controlXic/Maps_Tracker_Cockpit/docs/bike.png

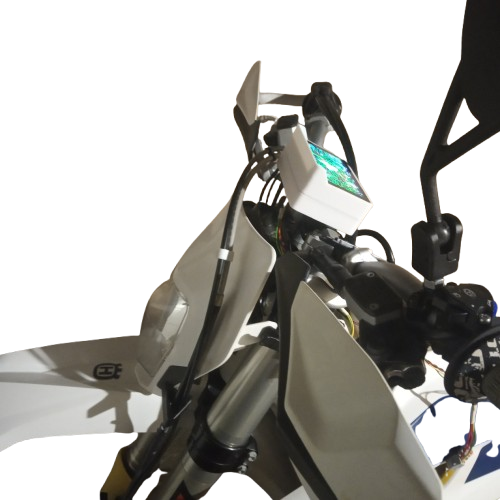
docs/bike.png
