controlXic/Maps_Tracker_Cockpit/docs/brd.png

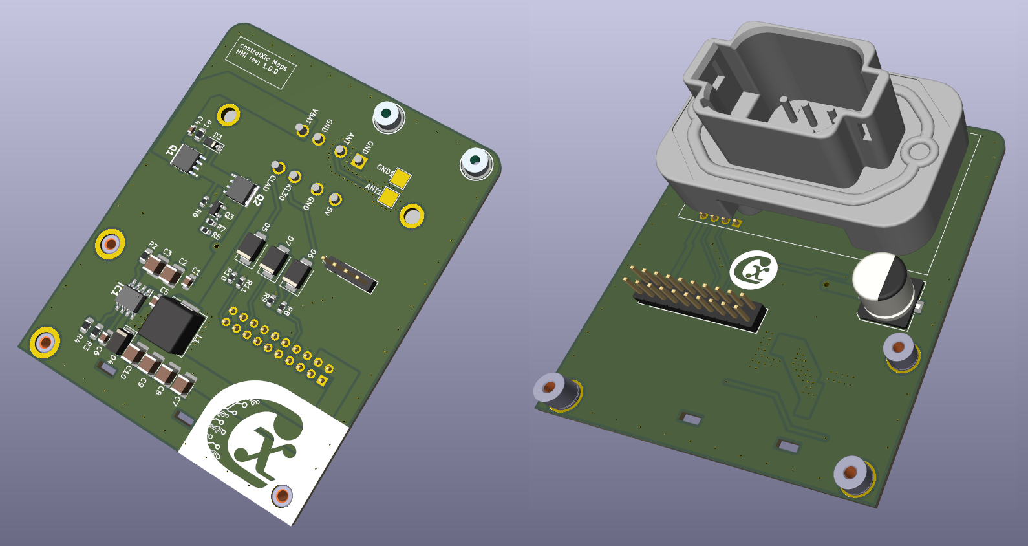
docs/brd.png
