controlXic/Maps_Tracker_Cockpit/docs/devB.png

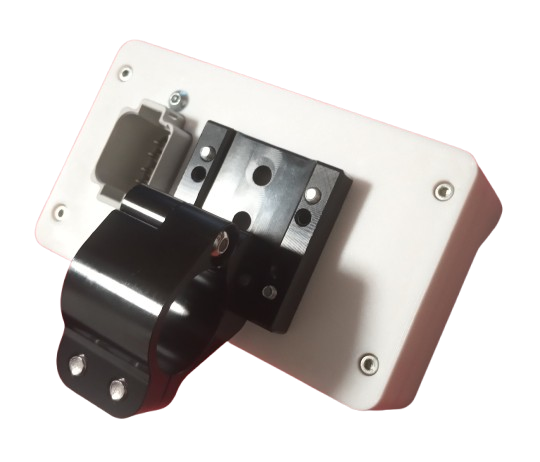
docs/devB.png
