controlXic/Maps_Tracker_Cockpit/docs/devFull.png

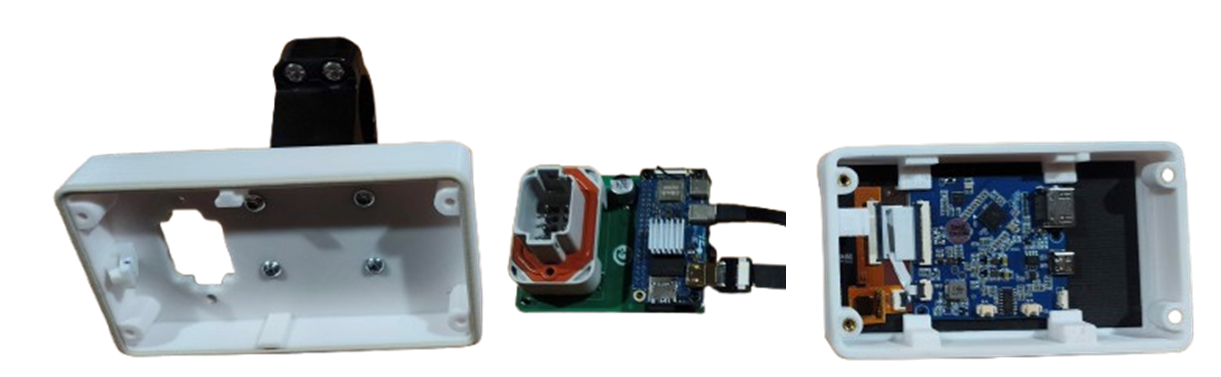
docs/devFull.png
