controlXic/Maps_Tracker_Cockpit/docs/devMoto.jpg

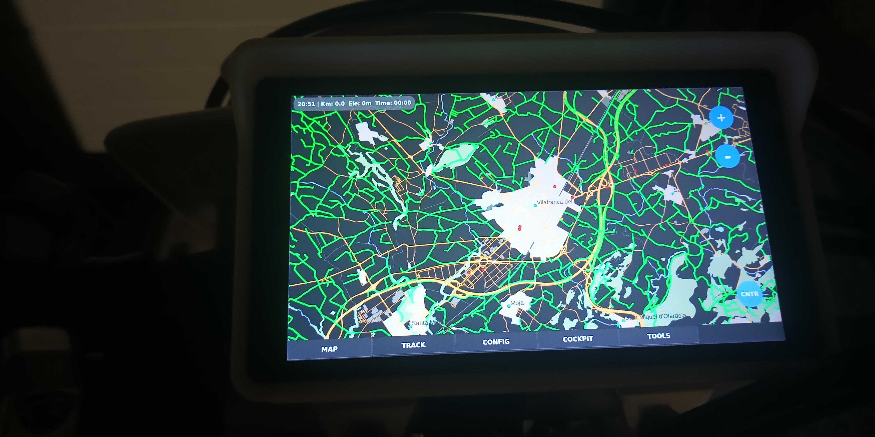
docs/devMoto.jpg
