controlXic/Maps_Tracker_Cockpit/docs/devT.png

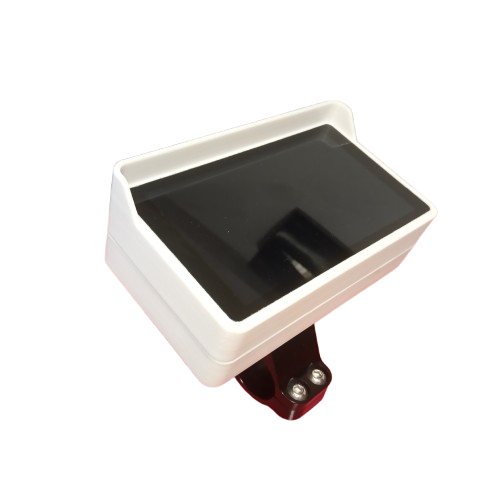
docs/devT.png
