controlXic/Maps_Tracker_Cockpit/docs/pcbB.png

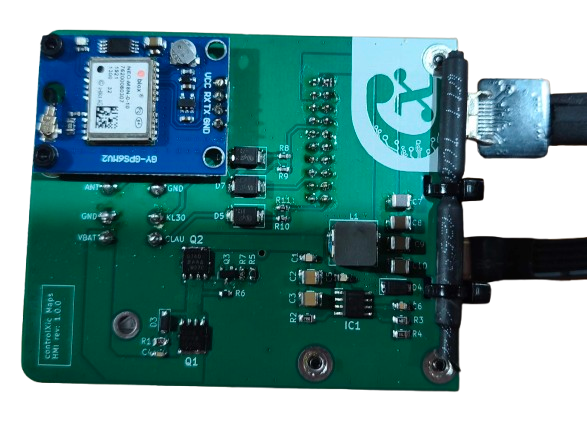
docs/pcbB.png
