controlXic/Maps_Tracker_Cockpit/01_PCB/PCB_C_X_mapsDevNmos/BOM/PCB_C_X_mapsDevNmos.xlsx

Id | Designator | Footprint | Quantity | Designation | Supplier and ref
12 | C1,C5 | C_0805_2012Metric_Pad1.18x1.45mm_HandSolder | 2 | 0.1uF
2 | C11 | CP_Elec_10x10.5 | 1 | C_Polarized_Small
16 | C3,C2 | C_1210_3225Metric_Pad1.33x2.70mm_HandSolder | 2 | 2.2uF
26 | C4 | C_0603_1608Metric | 1 | 15nF
17 | C6 | C_0805_2012Metric_Pad1.18x1.45mm_HandSolder | 1 | 22nF
10 | C7,C10,C9,C8 | C_1210_3225Metric_Pad1.33x2.70mm_HandSolder | 4 | 47uF
25 | D3 | D_SOD-123 | 1 | SZMMSZ5240BT1G
20 | D4 | Vishay_SMPA | 1 | V8PA22HM3/I
9 | D5,D6,D7 | D_SMB | 3 | MBRS120T3G
13 | GND,ANT | TestPoint_Pad_3.0x3.0mm | 2 | TestPoint
4 | H2,H3,H1 | SMTSOM252ET | 3 | SMTSO-M25-2ET
1 | H5,H4 | 9774027151R | 2 | 9774027151R
27 | IC1 | SOIC127P600X170-9N | 1 | LMR14050SSQDDARQ1
3 | J1 | DT1508PA | 1 | DT15-08PA
18 | J2 | PinHeader_1x04_P2.54mm_Vertical | 1 | Conn_01x04_Socket
5 | J4 | PinHeader_2x10_P2.54mm_Vertical | 1 | Conn_02x10_Odd_Even
24 | L1 | L_APV_APH0850 | 1 | 8.2uH
11 | Q1,Q2 | SQJA72EPT1_GE3 | 2 | SQJ403EP-T1_GE3
14 | Q3 | SOT-23 | 1 | SI2300DS-T1-BE3
22 | R1 | R_0805_2012Metric | 1 | 12k
19 | R11 | R_0603_1608Metric | 1 | 2k2
6 | R2 | R_0805_2012Metric_Pad1.20x1.40mm_HandSolder | 1 | 86k6
23 | R3 | R_0805_2012Metric_Pad1.20x1.40mm_HandSolder | 1 | 100k
21 | R4 | R_0805_2012Metric_Pad1.20x1.40mm_HandSolder | 1 | 17.8k
8 | R6,R7 | R_0603_1608Metric | 2 | 47k
7 | R8,R10,R5 | R_0603_1608Metric | 3 | 10k
15 | R9 | R_0603_1608Metric | 1 | 3k
Components contraconnector
 |  | DT06-08SA | 2
 |  | 0462-201-16141 | 20
 |  | W8S | 2
 |  | Revisar crimps contraconnecoor
Cistella
https://www.mouser.es/es/Tools/SavedCart/Share?AccessID=dd964511a3
