controlXic/Maps_Tracker_Cockpit/02_CAD/01_STL/devBottom.stl

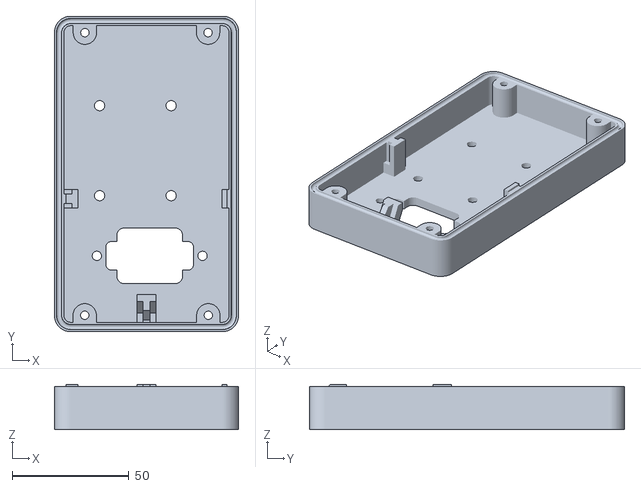
[picture p10: CAD file, 2026-11-03]
02_CAD/01_STL/devBottom.stl
78.7 x 134.9 x 19.4
