controlXic/Maps_Tracker_Cockpit/02_CAD/01_STL/5inch-720x1280-lcd_3D_Drawing.stl

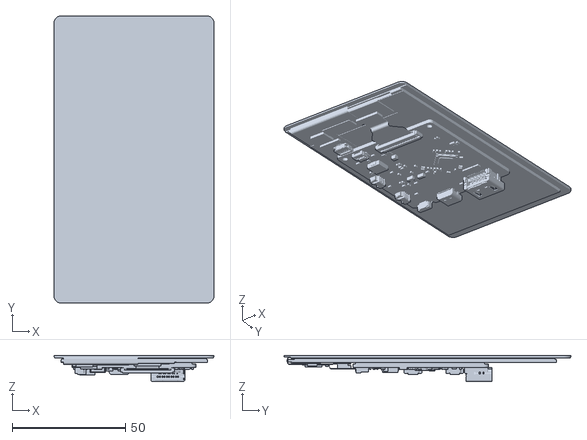
[picture p11: CAD file, 2026-11-03]
02_CAD/01_STL/5inch-720x1280-lcd_3D_Drawing.stl
70.7 x 126.9 x 11.6
