controlXic/Maps_Tracker_Cockpit/02_CAD/01_STL/devTop.stl

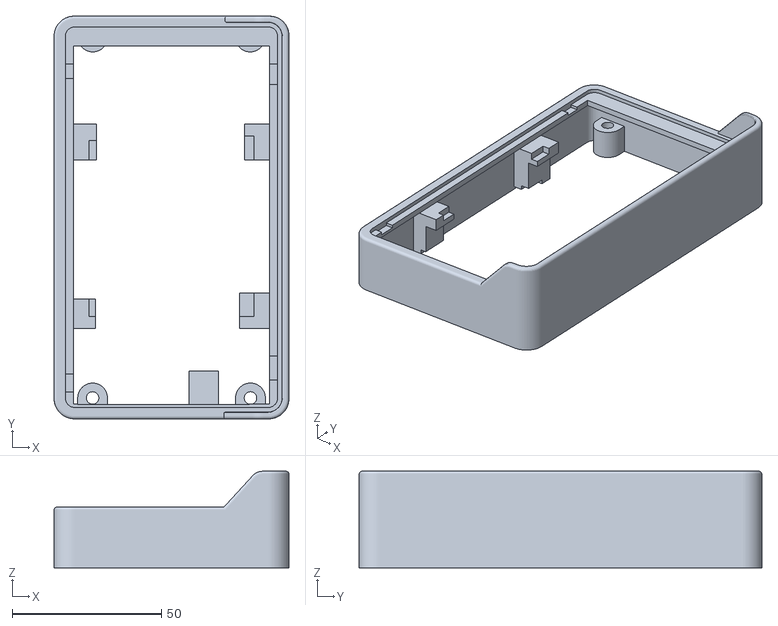
[picture p12: CAD file, 2026-11-03]
02_CAD/01_STL/devTop.stl
78.7 x 134.9 x 32.4
