controlXic/Maps_Tracker_Cockpit/(list of files, cad)

Other CAD files:
02_CAD/00_WORK/cx_maps_case-utils.skp
