controlXic/Maps_Tracker_Cockpit/01_PCB/PCB_C_X_mapsDevNmos/PCB_C_X_mapsDevNmos.kicad_pcb

## KiCad design 01_PCB/PCB_C_X_mapsDevNmos/PCB_C_X_mapsDevNmos.kicad_pcb (2026-11-03)

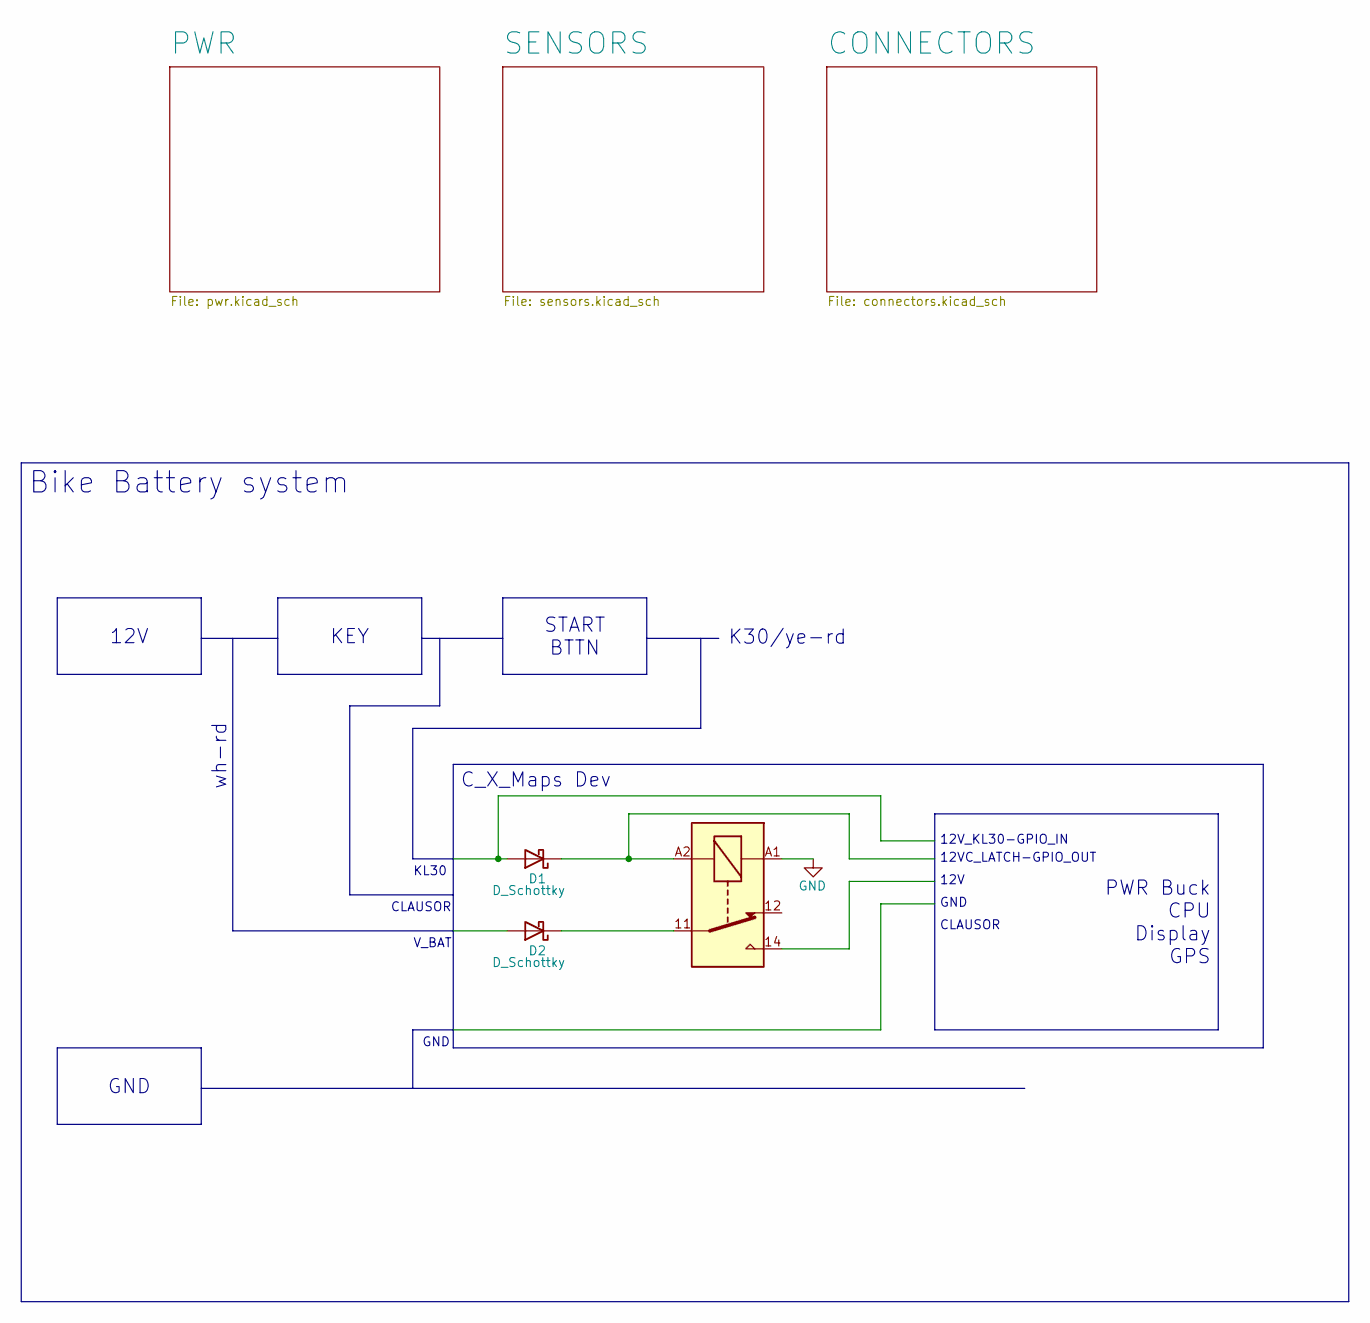
[picture p13: schematic PCB_C_X_mapsDevNmos.kicad_sch]

Parts:
D1, D2: D_Schottky; Vishay_SMPA
K1: Fujitsu_FTR-LYCA005x; Relay_SPDT_Fujitsu_FTR-LYCA005x_FormC_Vertical

Connections:
unnamed: D1.1 (K), K1.A2
unnamed: D2.1 (K), K1.11

Notes on the sheet:
CLAUSOR
12VC_LATCH-GPIO_OUT
V_BAT
GND
KL30
12V
wh-rd
K30/ye-rd
12V_KL30-GPIO_IN
START BTTN
Bike Battery system
PWR Buck CPU Display GPS
KEY
C_X_Maps Dev

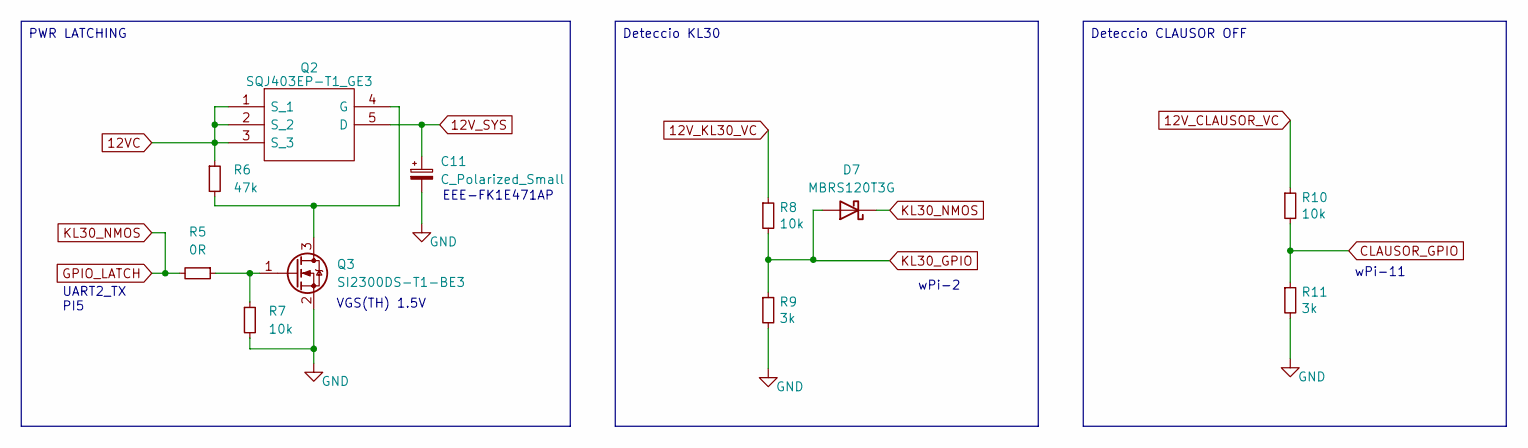
[picture p14: schematic sensors.kicad_sch]

Parts:
C11: C_Polarized_Small; CP_Elec_10x10.5
D7: MBRS120T3G; D_SMB
Q2: SQJ403EP-T1_GE3; SQJA72EPT1_GE3; Manufacturer_Part_Number SQJ481EP-T1_GE3; Mouser Part Number 78-SQJ481EP-T1_GE3
Q3: SI2300DS-T1-BE3; SOT-23
R5: 0R; R_0603_1608Metric
R6: 47k; R_0603_1608Metric
R7, R8, R10: 10k; R_0603_1608Metric
R9, R11: 3k; R_0603_1608Metric

Connections:
12VC: Q2.1 (S_1), Q2.2 (S_2), Q2.3 (S_3), R6.1; also elsewhere on the board
12V_CLAUSOR_VC: R10.1; also elsewhere on the board
12V_KL30_VC: R8.1; also elsewhere on the board
12V_SYS: C11.1, Q2.5 (D); also elsewhere on the board
CLAUSOR_GPIO: R10.2, R11.1; also elsewhere on the board
GND: C11.2, Q3.2 (S), R7.2, R9.2, R11.2; also elsewhere on the board
GPIO_LATCH: D7.1 (K), R5.2; also elsewhere on the board
KL30_GPIO: D7.2 (A), R8.2, R9.1; also elsewhere on the board
unnamed: Q2.4 (G), Q3.3 (D), R6.2
unnamed: Q3.1 (G), R5.1, R7.1

Notes on the sheet:
VGS(TH) 1.5V
wPi-11
EEE-FK1E471AP
wPi-2
UART2_TX PI5
Deteccio CLAUSOR OFF
Deteccio KL30
PWR LATCHING

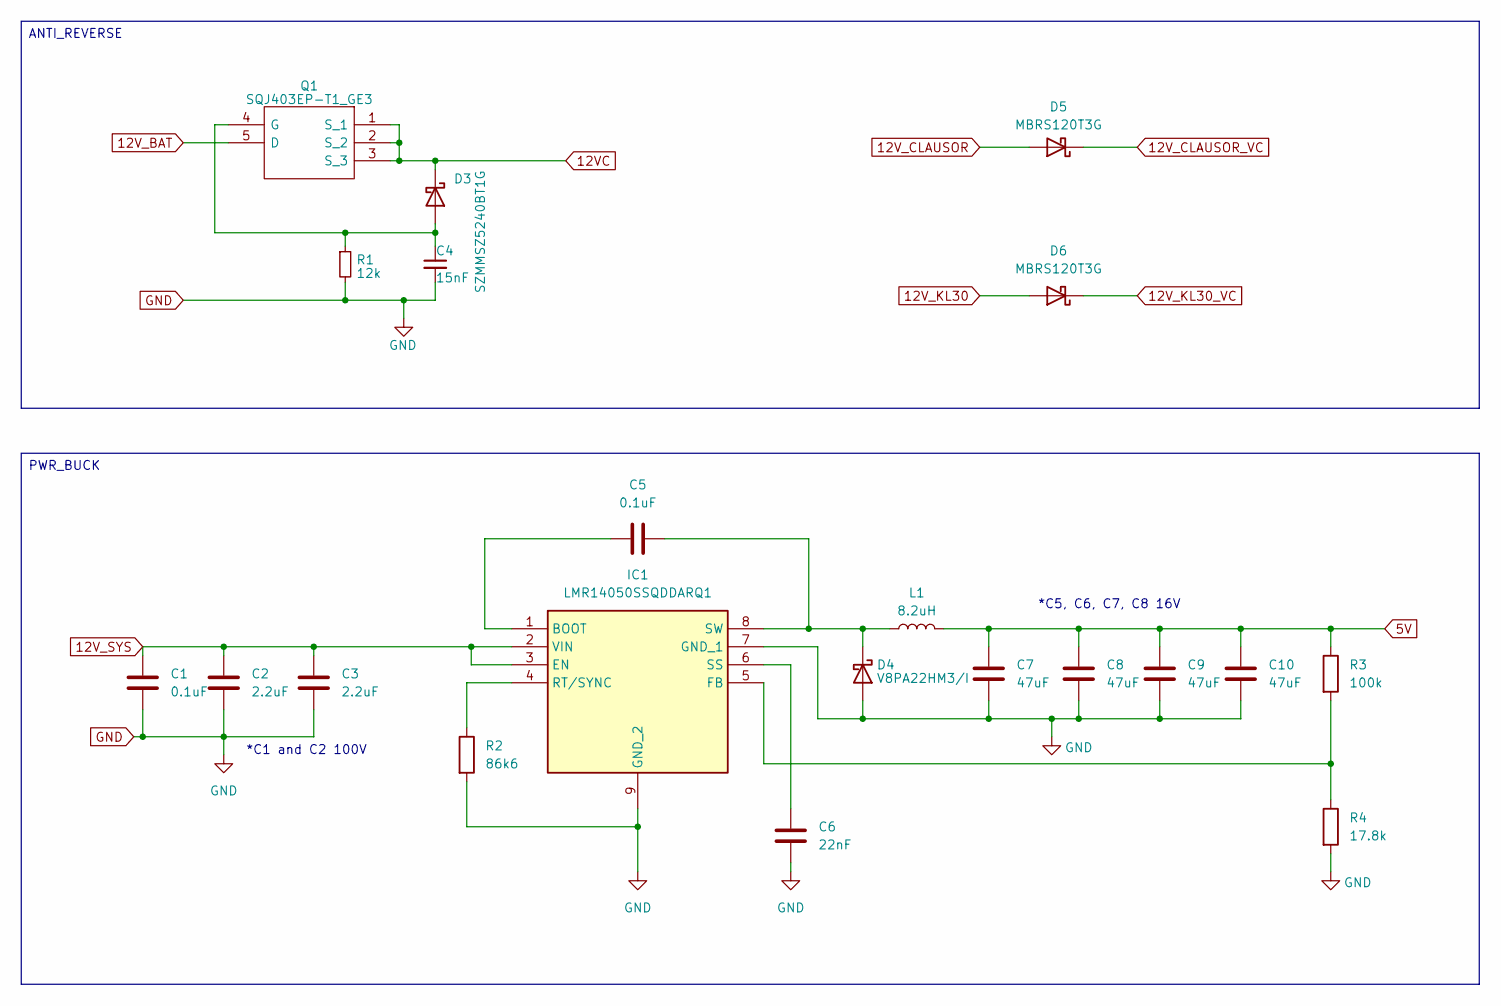
[picture p15: schematic pwr.kicad_sch]

Parts:
C1, C5: 0.1uF; C_0805_2012Metric_Pad1.18x1.45mm_HandSolder
C2, C3: 2.2uF; C_1210_3225Metric_Pad1.33x2.70mm_HandSolder
C4: 15nF; C_0603_1608Metric
C6: 22nF; C_0805_2012Metric_Pad1.18x1.45mm_HandSolder
C7, C8, C9, C10: 47uF; C_1210_3225Metric_Pad1.33x2.70mm_HandSolder
D3: SZMMSZ5240BT1G; D_SOD-123
D4: V8PA22HM3/I; Vishay_SMPA
D5, D6: MBRS120T3G; D_SMB
IC1: LMR14050SSQDDARQ1; SOIC127P600X170-9N; Mouser Part Number 595-LMR14050SSDDARQ1
L1: 8.2uH; L_APV_APH0850
Q1: SQJ403EP-T1_GE3; SQJA72EPT1_GE3; Manufacturer_Part_Number SQJ481EP-T1_GE3; Mouser Part Number 78-SQJ481EP-T1_GE3
R1: 12k; R_0805_2012Metric
R2: 86k6; R_0805_2012Metric_Pad1.20x1.40mm_HandSolder
R3: 100k; R_0805_2012Metric_Pad1.20x1.40mm_HandSolder
R4: 17.8k; R_0805_2012Metric_Pad1.20x1.40mm_HandSolder

Connections:
5V: C7.1, C8.1, C9.1, C10.1, L1.2, R3.1; also elsewhere on the board
12VC: D3.1 (K), Q1.1 (S_1), Q1.2 (S_2), Q1.3 (S_3); also elsewhere on the board
12V_BAT: Q1.5 (D); also elsewhere on the board
12V_CLAUSOR: D5.2 (A); also elsewhere on the board
12V_CLAUSOR_VC: D5.1 (K); also elsewhere on the board
12V_KL30: D6.2 (A); also elsewhere on the board
12V_KL30_VC: D6.1 (K); also elsewhere on the board
12V_SYS: C1.1, C2.1, C3.1, IC1.2 (VIN), IC1.3 (EN); also elsewhere on the board
GND: C1.2, C2.2, C3.2, C4.2, C6.2, C7.2, C8.2, C9.2, C10.2, D4.2 (A), IC1.7 (GND_1), IC1.9 (GND_2), R1.2, R2.2, R4.2; also elsewhere on the board
unnamed: C4.1, D3.2 (A), Q1.4 (G), R1.1
unnamed: C5.1, D4.1 (K), IC1.8 (SW), L1.1
unnamed: C5.2, IC1.1 (BOOT)
unnamed: IC1.5 (FB), R3.2, R4.1
unnamed: IC1.4 (RT/SYNC), R2.1
unnamed: C6.1, IC1.6 (SS)

Notes on the sheet:
*C1 and C2 100V
*C5, C6, C7, C8 16V
ANTI_REVERSE
PWR_BUCK

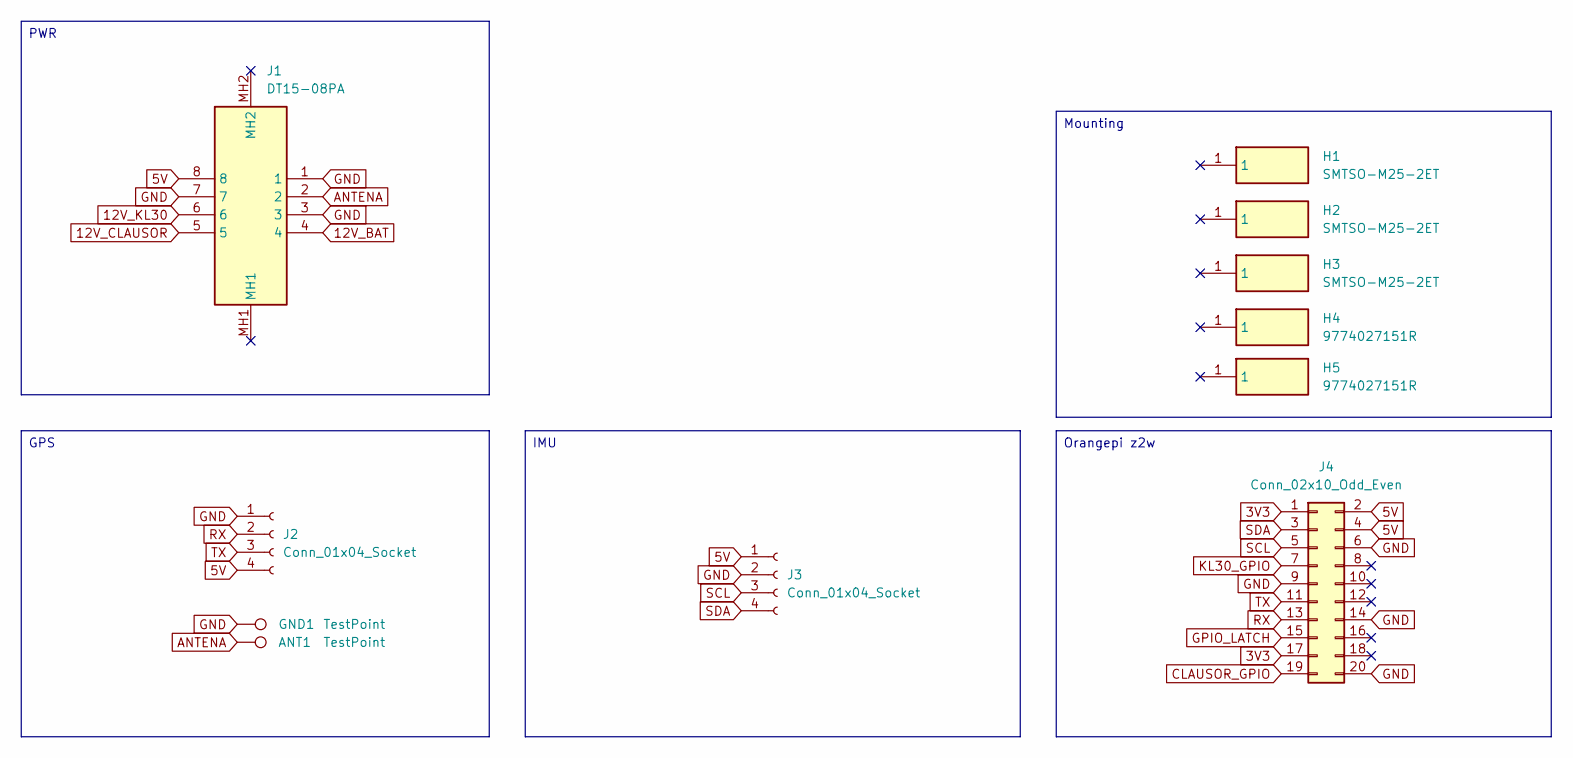
[picture p16: schematic connectors.kicad_sch]

Parts:
ANT1: TestPoint; TestPoint_Pad_3.0x3.0mm
GND1: TestPoint; TestPoint_Pad_3.0x3.0mm
H1, H2, H3: SMTSO-M25-2ET; SMTSOM252ET; Manufacturer_Part_Number SMTSO-M25-2ET; Mouser Part Number 153-SMTSO-M25-2ET
H4, H5: 9774027151R; Manufacturer_Part_Number 9774027151R; Mouser Part Number 710-9774027151R
J1: DT15-08PA; DT1508PA; Manufacturer_Part_Number DT15-08PA
J2, J3: Conn_01x04_Socket; PinHeader_1x04_P2.54mm_Vertical
J4: Conn_02x10_Odd_Even; PinHeader_2x10_P2.54mm_Vertical

Connections:
3V3: J4.1, J4.17
5V: J1.8, J2.4, J3.1, J4.2, J4.4; also elsewhere on the board
12V_BAT: J1.4; also elsewhere on the board
12V_CLAUSOR: J1.5; also elsewhere on the board
12V_KL30: J1.6; also elsewhere on the board
ANTENA: ANT1.1, J1.2
CLAUSOR_GPIO: J4.19; also elsewhere on the board
GND: GND1.1, J1.1, J1.3, J1.7, J2.1, J3.2, J4.6, J4.9, J4.14, J4.20; also elsewhere on the board
GPIO_LATCH: J4.15; also elsewhere on the board
KL30_GPIO: J4.7; also elsewhere on the board
RX: J2.2, J4.13
SCL: J3.3, J4.5
SDA: J3.4, J4.3
TX: J2.3, J4.11

Notes on the sheet:
Mounting
IMU
Orangepi z2w
PWR
GPS

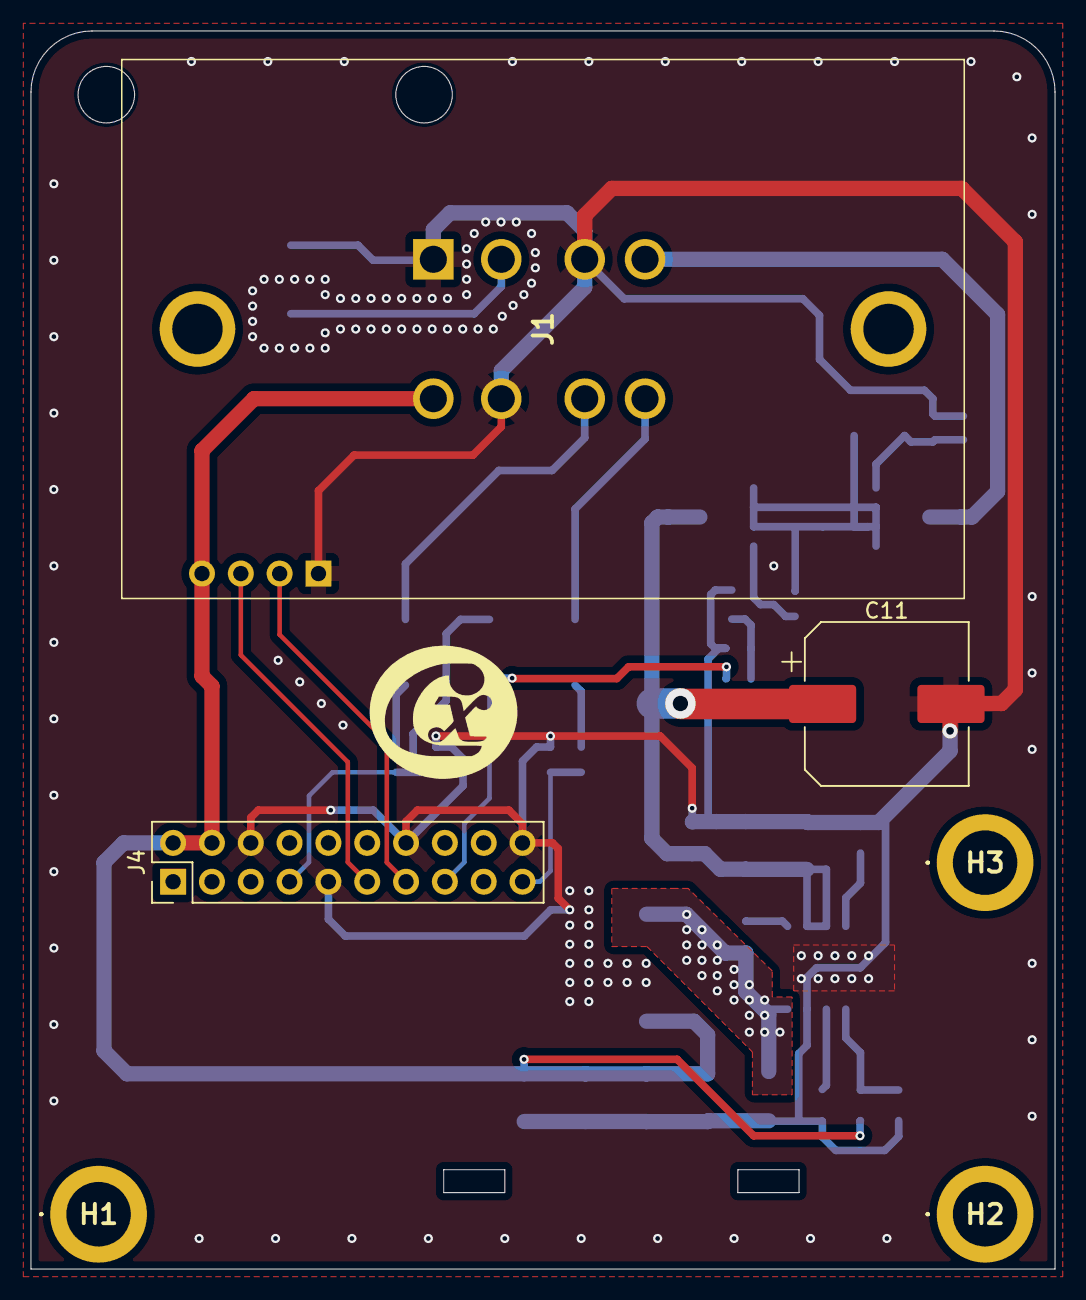
[picture p17: board PCB_C_X_mapsDevNmos.kicad_pcb from above]

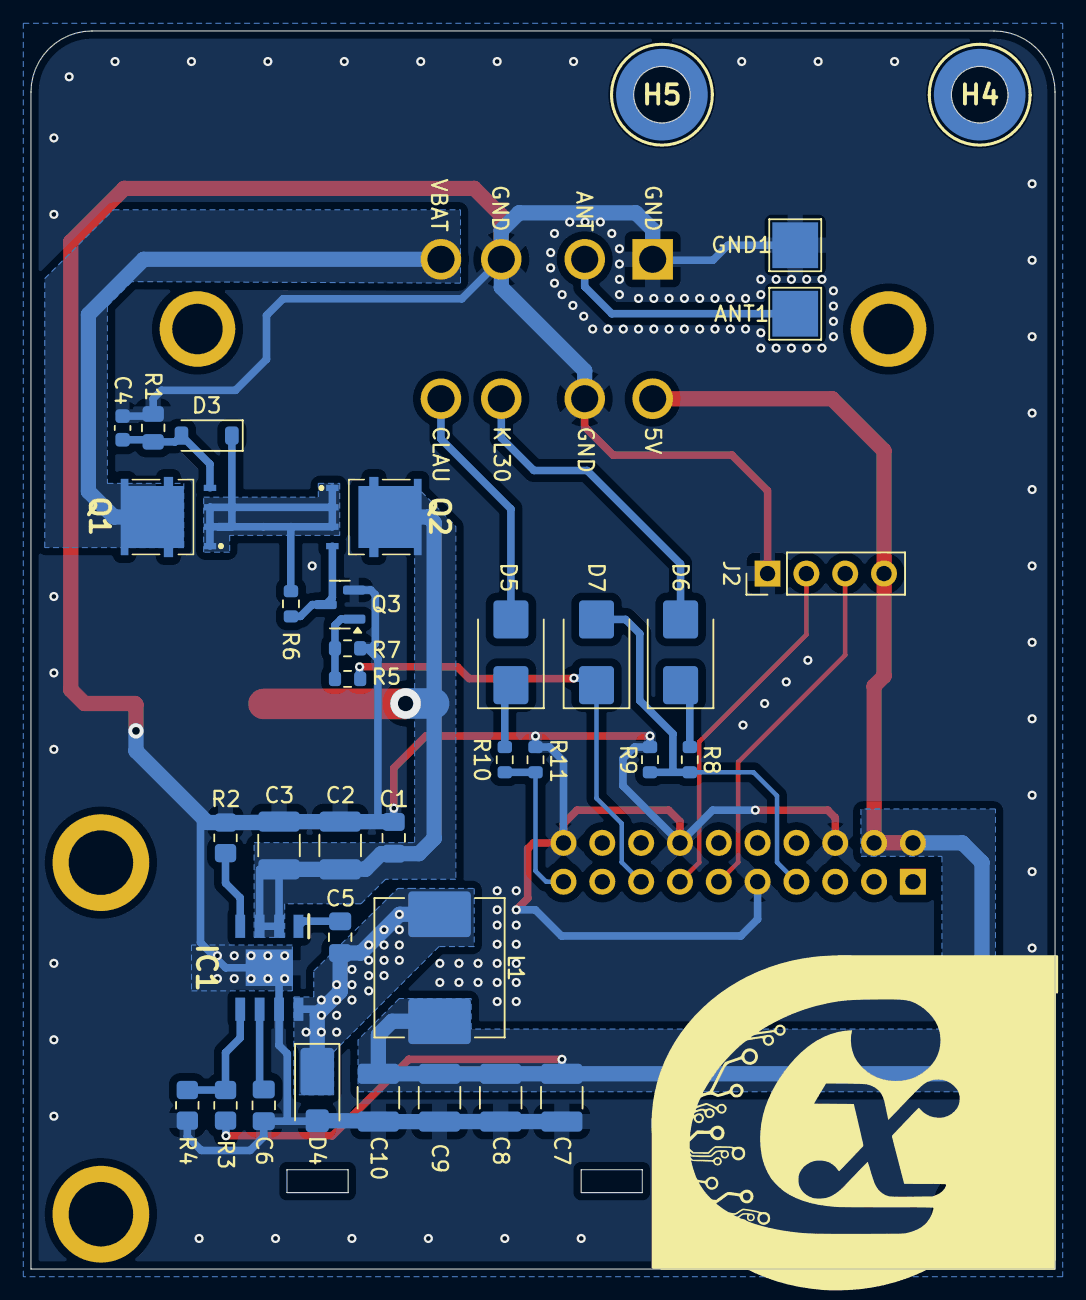
[picture p18: board PCB_C_X_mapsDevNmos.kicad_pcb from below]

Board: 2 copper layers, 67.0 x 81.0 mm, 42 parts (36 on the bottom side), 24 nets.
